Coolstep/OpenLogger_SubD/README.md

# OpenLogger_SubD
Based on OpenLog by SparkFun I created a SubD "Black Box" Dongle 

For more information see: http://fullstackengineer.tech/blog/2021/01/12/robust-black-box-for-mobile-applications/
