Coolstep/OpenLogger_SubD/Production/Logger_BOM.xlsx

Id | Designator | Package | Quantity | Designation | Supplier and ref
1 | C1 | 0603-POL | 1 | Tantalum cap - SMD 10uF 10V 20% 0603 | F981A106MMA | AVX | https://www.mouser.de/ProductDetail/AVX/F981A106MMA
2 | C4,C3,C2 | 0603-CAP | 3 | CAP CER 100 nF ≥35V 10% X7R 0603 | C0603C104J5RAC7411 | KEMET | C0603C104J5RAC7411 (https://www.mouser.de/ProductDetail/KEMET/C0603C104J5RAC7411?qs=sGAEpiMZZMs0AnBnWHyRQHAHiYZ1GaYqBF4voyGoJPE%3d)
3 | D1 | LED-0603 | 1 | BLUE | 150060BS75000 | Wurth Elektronik | https://www.mouser.de/ProductDetail/Wurth-Elektronik/150060BS75000
4 | D3 | LED-0603 | 1 | GREEN | 150060VS75000 | Wurth Elektronik | https://www.mouser.de/ProductDetail/Wurth-Elektronik/150060VS75000
6 | J2 | DSUB-9_Female_EdgeMount_P2.77mm | 1 | DB9_Female with solder Cups | Local manufuctured |  | or Amphenol | L77SDE09S (https://www.mouser.de/ProductDetail/Amphenol-Commercial-Products/L77SDE09S)
7 | Q1 | RESONATOR-SMD | 1 | Resonators 16MHZ .5% CHIP | CSTNE16M0V530000R0 | Murata Electronics | https://www.mouser.de/ProductDetail/Murata-Electronics/CSTNE16M0V530000R0
8 | R2 | 0603-RES | 1 | Res 10k, ≤5%, ≥75V | ERJ-U03J103V | Panasonic | https://www.mouser.de/ProductDetail/Panasonic/ERJ-U03J103V
9 | R1,R3,R6 | 0603-RES | 3 | Res 1k, ≤5%, ≥75V | ERJ-U03J102V | Panasonic | https://www.mouser.de/ProductDetail/Panasonic/ERJ-U03J102V
10 | R4 | 0603-RES | 1 | Res 2k, ≤5%, ≥75V | ERJ-U03J202V | Panasonic | https://www.mouser.de/ProductDetail/Panasonic/ERJ-U03J202V
12 | U1 | TQFP32-08 | 1 | ATMEGA328P-AU | ATMEGA328P-AU | Microchip | https://www.mouser.de/ProductDetail/Microchip-Technology-Atmel/ATMEGA328P-AU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
13 | U2 | SOT23-5 | 1 | 3.3V MIC5205 | MIC5205-3.3YM5-TR | Microchip | https://www.mouser.de/ProductDetail/Microchip-Technology-Micrel/MIC5205-33YM5-TR
14 | U3 | MICROSD_1_1 | 1 | microSD Socket | 104031-0811 | molex | https://www.mouser.de/ProductDetail/Molex/104031-0811?qs=udsGRKD4nA3Tvy7wqky%252BuA%3D%3D
 |  |  | 16
