Coolstep/OpenLogger_SubD/PCB/Step/anschluss_a-df_09_ll_z.STEP

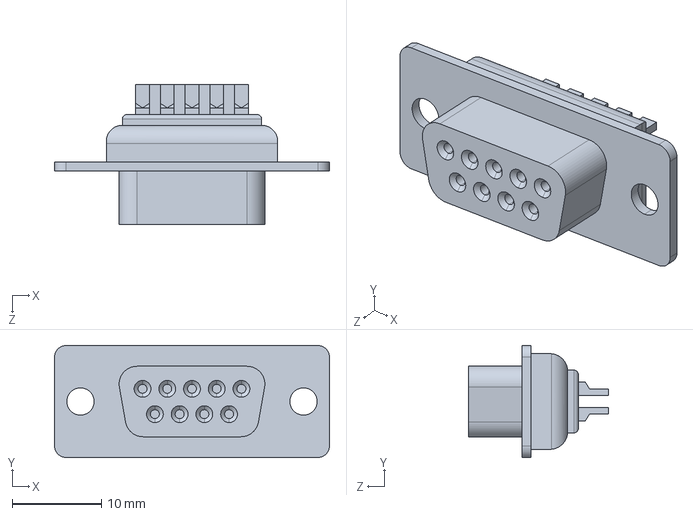
[picture p1: CAD file, 2021-01-12]
PCB/Step/anschluss_a-df_09_ll_z.STEP
30.8 x 12.6 x 15.7 mm
