Coolstep/OpenLogger_SubD/PCB/Step/micro SD Card Slot.step

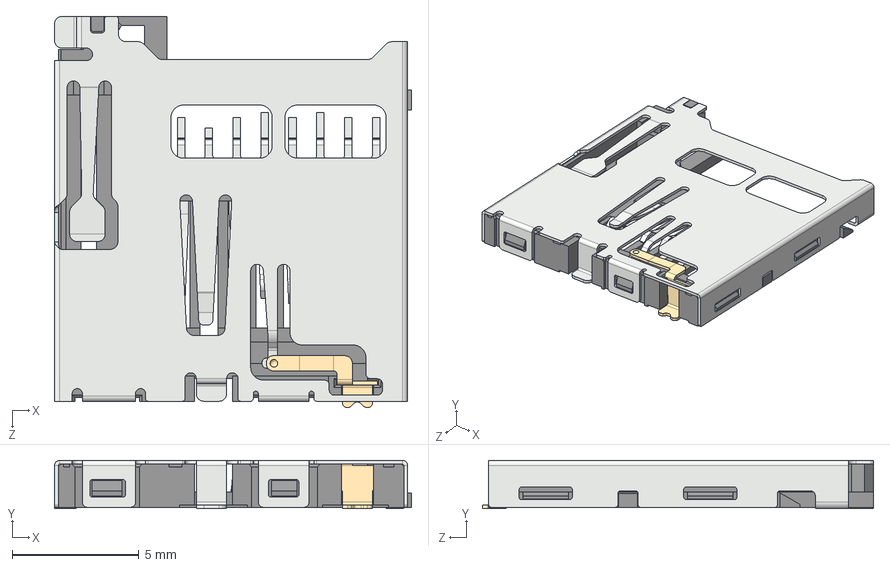
[picture p2: CAD file, 2021-01-12]
PCB/Step/micro SD Card Slot.step
14.1 x 1.90 x 15.5 mm
microSD_Body
microSD_Cover
microSD_Card_Detect
microSD_Pin_11.15 x 5
microSD_Pin_11.35 x 2
microSD_Pin_10.75
