Coolstep/OpenLogger_SubD/PCB/Step/1040310811.stp

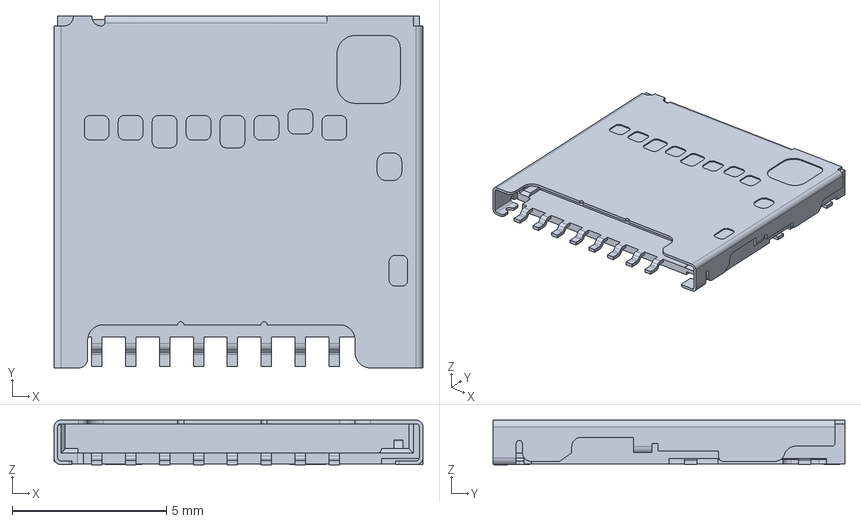
[picture p3: CAD file, 2021-01-12]
PCB/Step/1040310811.stp
11.9 x 11.4 x 1.45 mm
