Coolstep/OpenLogger_SubD/PCB/Wegard_Logger.kicad_pcb

## KiCad design PCB/Wegard_Logger.kicad_pcb (2021-01-12)

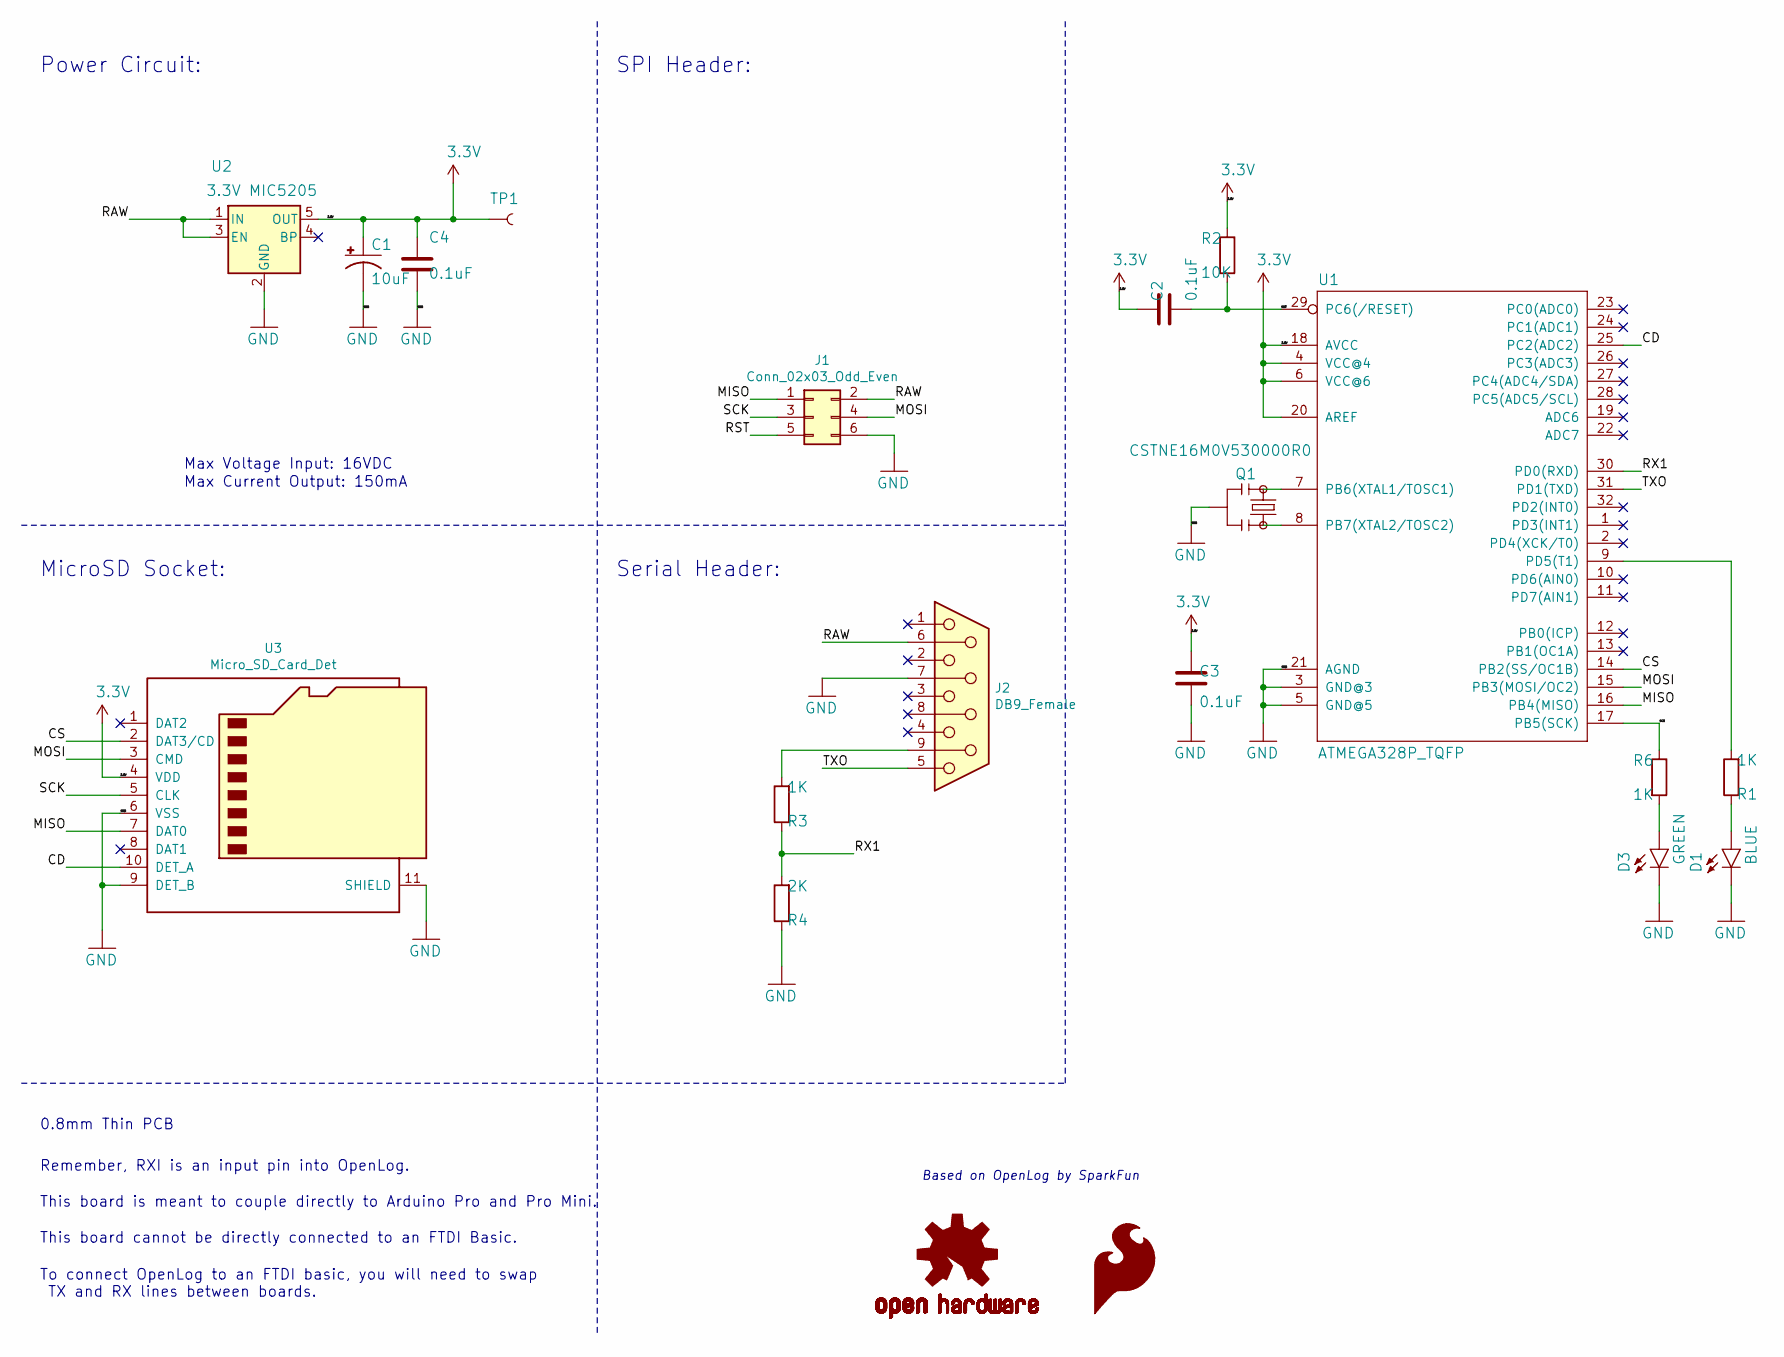
[picture p4: schematic Wegard_Logger.sch]

Parts:
C1: 10uF; 0603-POL
C2, C3, C4: 0.1uF; C_0603_1608Metric
D1: BLUE; LED-0603
D3: GREEN; LED-0603
J1: Conn_02x03_Odd_Even; Tag-Connect_TC2030-IDC-NL_2x03_P1.27mm_Vertical
J2: DB9_Female; DSUB-9_Female_EdgeMount_P2.77mm
Q1: CSTNE16M0V530000R0; Resonator_SMD_muRata_CSTxExxV-3Pin_3.0x1.1mm
R1, R3, R6: 1K; R_0603_1608Metric
R2: 10K; R_0603_1608Metric
R4: 2K; R_0603_1608Metric
TP1: TEST-POINT3; PAD.03X.03
U1: ATMEGA328P_TQFP; TQFP32-08
U2: 3.3V MIC5205; SOT-23-5
U3: Micro_SD_Card_Det; microSD_HC_Molex_104031-0811

Connections:
3.3V: C1.A (+), C2.2, C3.2, C4.1, R2.1, TP1.P$1, U1.4 (VCC@4), U1.6 (VCC@6), U1.18 (AVCC), U1.20 (AREF), U2.5 (OUT), U3.4 (VDD)
/CD: U1.25 (PC2(ADC2)), U3.10 (DET_A)
/CS: U1.14 (PB2(SS/OC1B)), U3.2 (DAT3/CD)
/MISO: J1.1, U1.16 (PB4(MISO)), U3.7 (DAT0)
/MOSI: J1.4, U1.15 (PB3(MOSI/OC2)), U3.3 (CMD)
/RAW: J1.2, J2.6, U2.1 (IN), U2.3 (EN)
/RST: C2.1, J1.5, R2.2, U1.29 (PC6(/RESET))
/RX1: R3.1, R4.2, U1.30 (PD0(RXD))
/SCK: J1.3, R6.1, U1.17 (PB5(SCK)), U3.5 (CLK)
/TXO: J2.5, U1.31 (PD1(TXD))
GND: C1.K (-), C3.1, C4.2, D1.C, D3.C, J1.6, J2.7, Q1.2, R4.1, U1.3 (GND@3), U1.5 (GND@5), U1.21 (AGND), U2.2 (GND), U3.6 (VSS), U3.9 (DET_B), U3.11 (SHIELD)
unnamed: D1.A, R1.1
unnamed: D3.A, R6.2
unnamed: J2.9, R3.2
unnamed: Q1.1, U1.8 (PB7(XTAL2/TOSC2))
unnamed: Q1.3, U1.7 (PB6(XTAL1/TOSC1))
unnamed: R1.2, U1.9 (PD5(T1))

Notes on the sheet:
Max Voltage Input: 16VDC
Max Current Output: 150mA
Remember, RXI is an input pin into OpenLog.
This board is meant to couple directly to Arduino Pro and Pro Mini.
This board cannot be directly connected to an FTDI Basic.
To connect OpenLog to an FTDI basic, you will need to swap TX and RX lines between boards.
0.8mm Thin PCB
Power Circuit:
Serial Header:
MicroSD Socket:
SPI Header:
Based on OpenLog by SparkFun

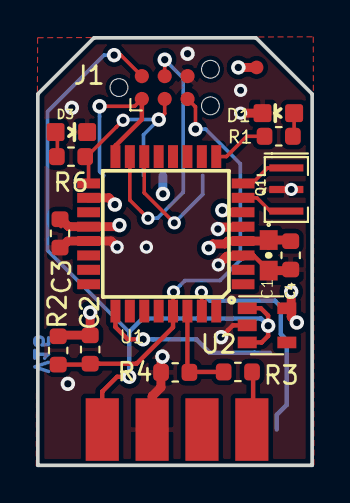
[picture p5: board Wegard_Logger.kicad_pcb from above]

Board: 4 copper layers, 15.2 x 23.8 mm, 18 parts (0 on the bottom side), 17 nets.
